VitaliMostowoj/dawcontrol_hw/dawcontrol.kicad_sch

## KiCad design dawcontrol.kicad_sch (2026-11-02)

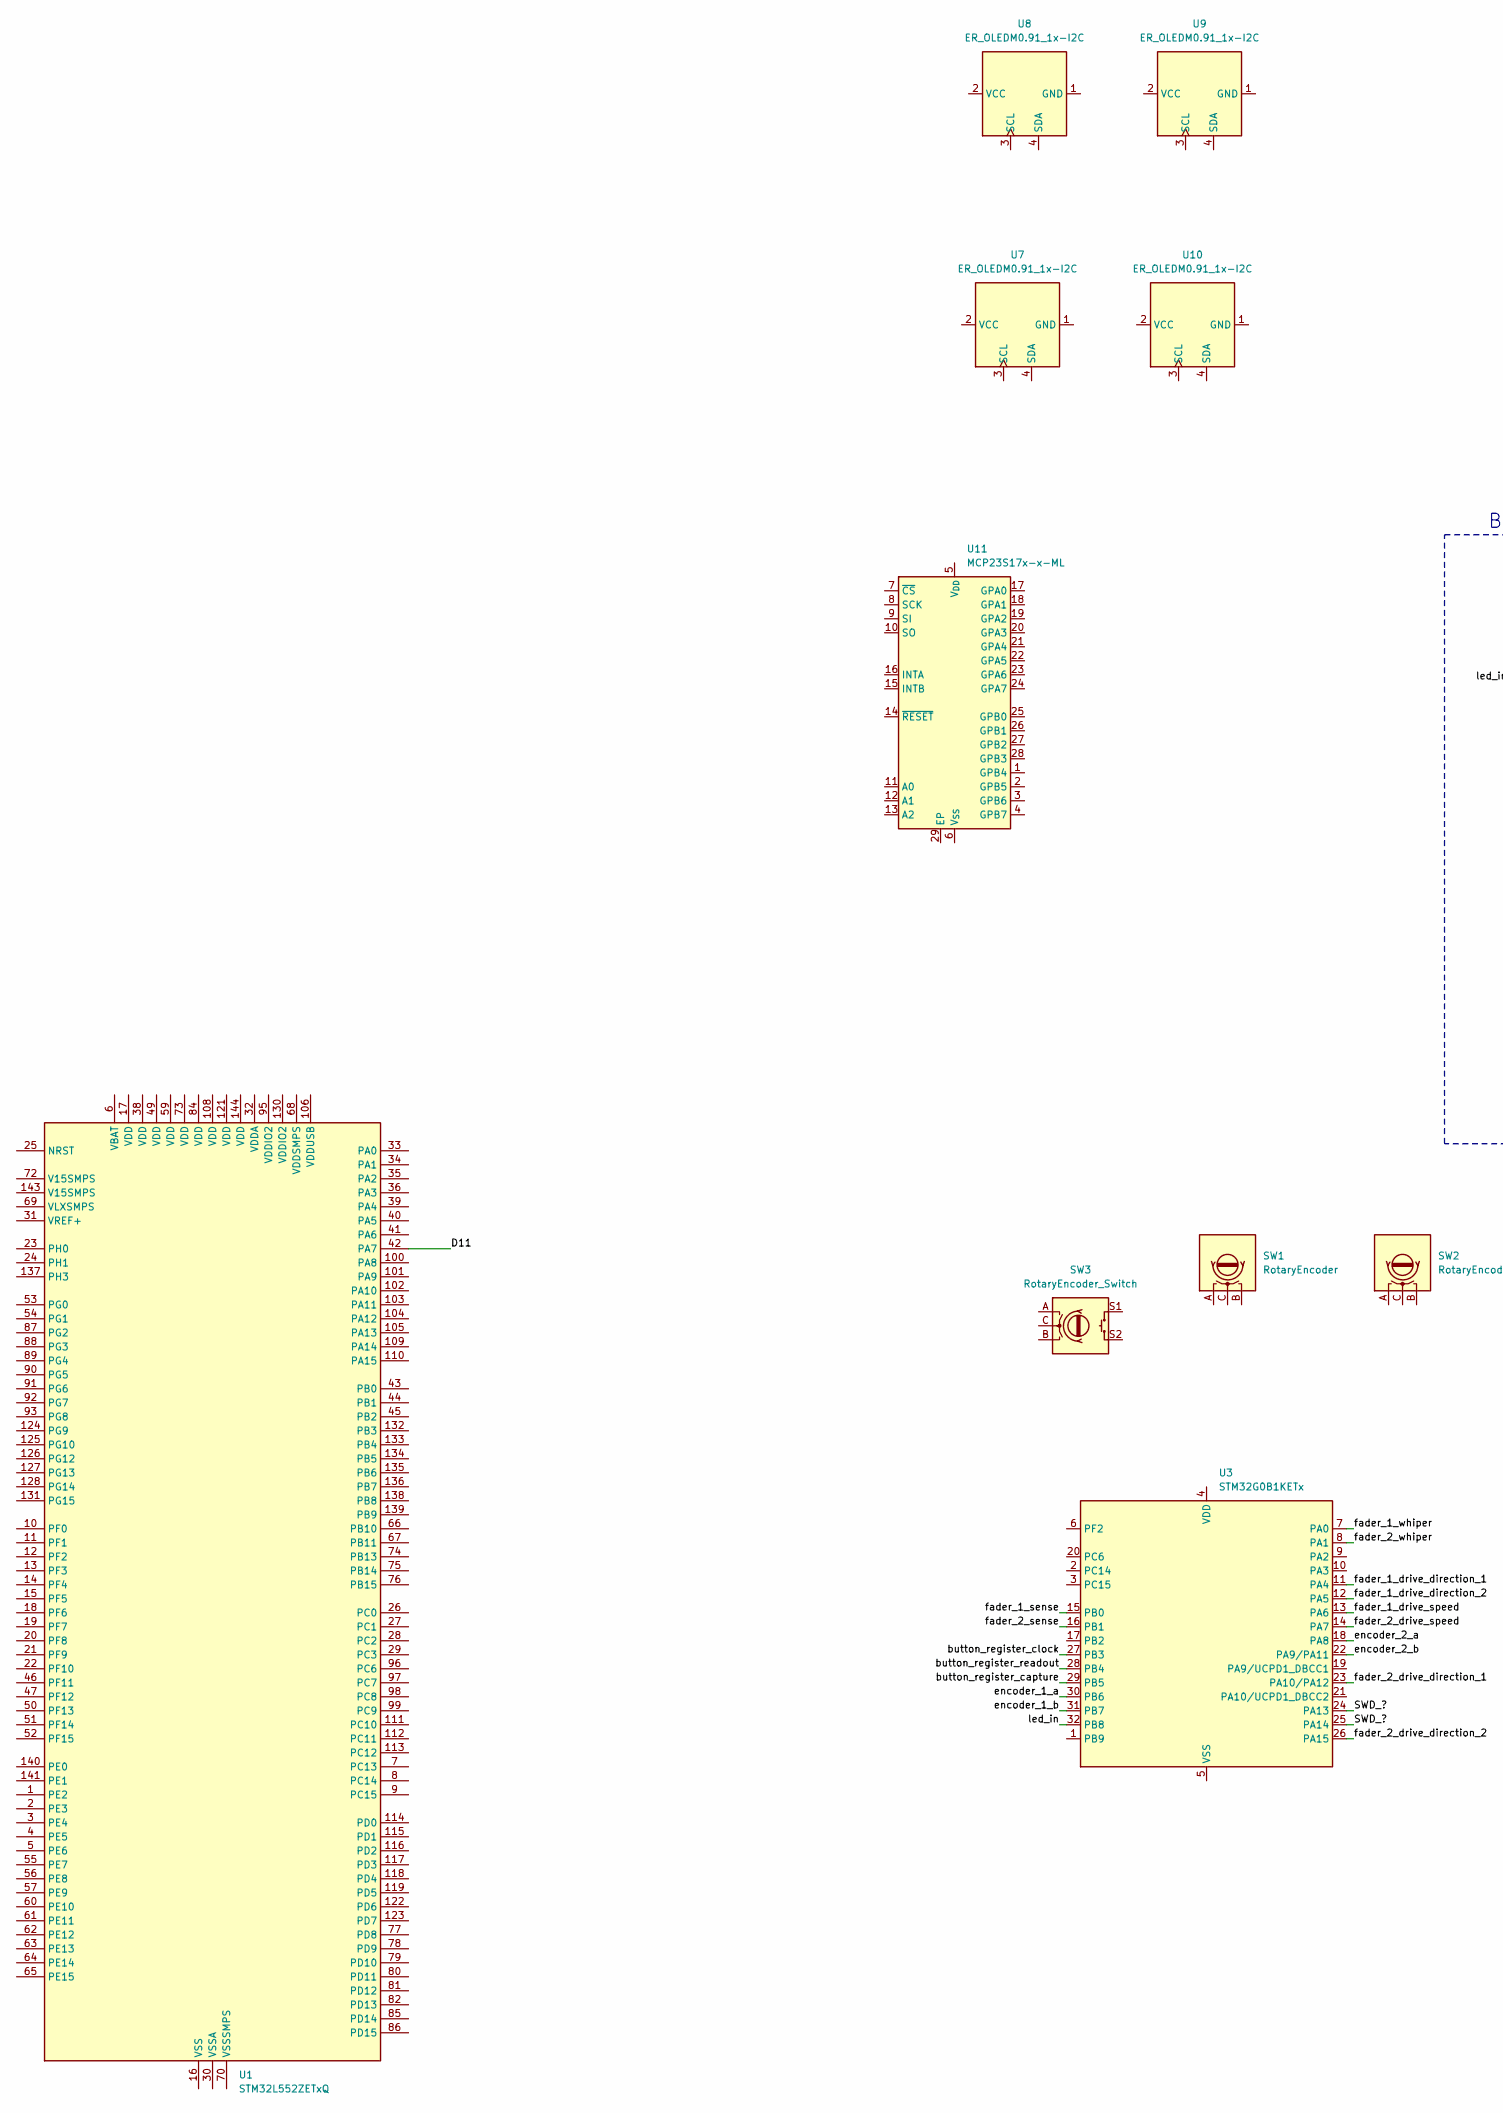
[picture p1: schematic dawcontrol.kicad_sch, part in row 1, column 1]

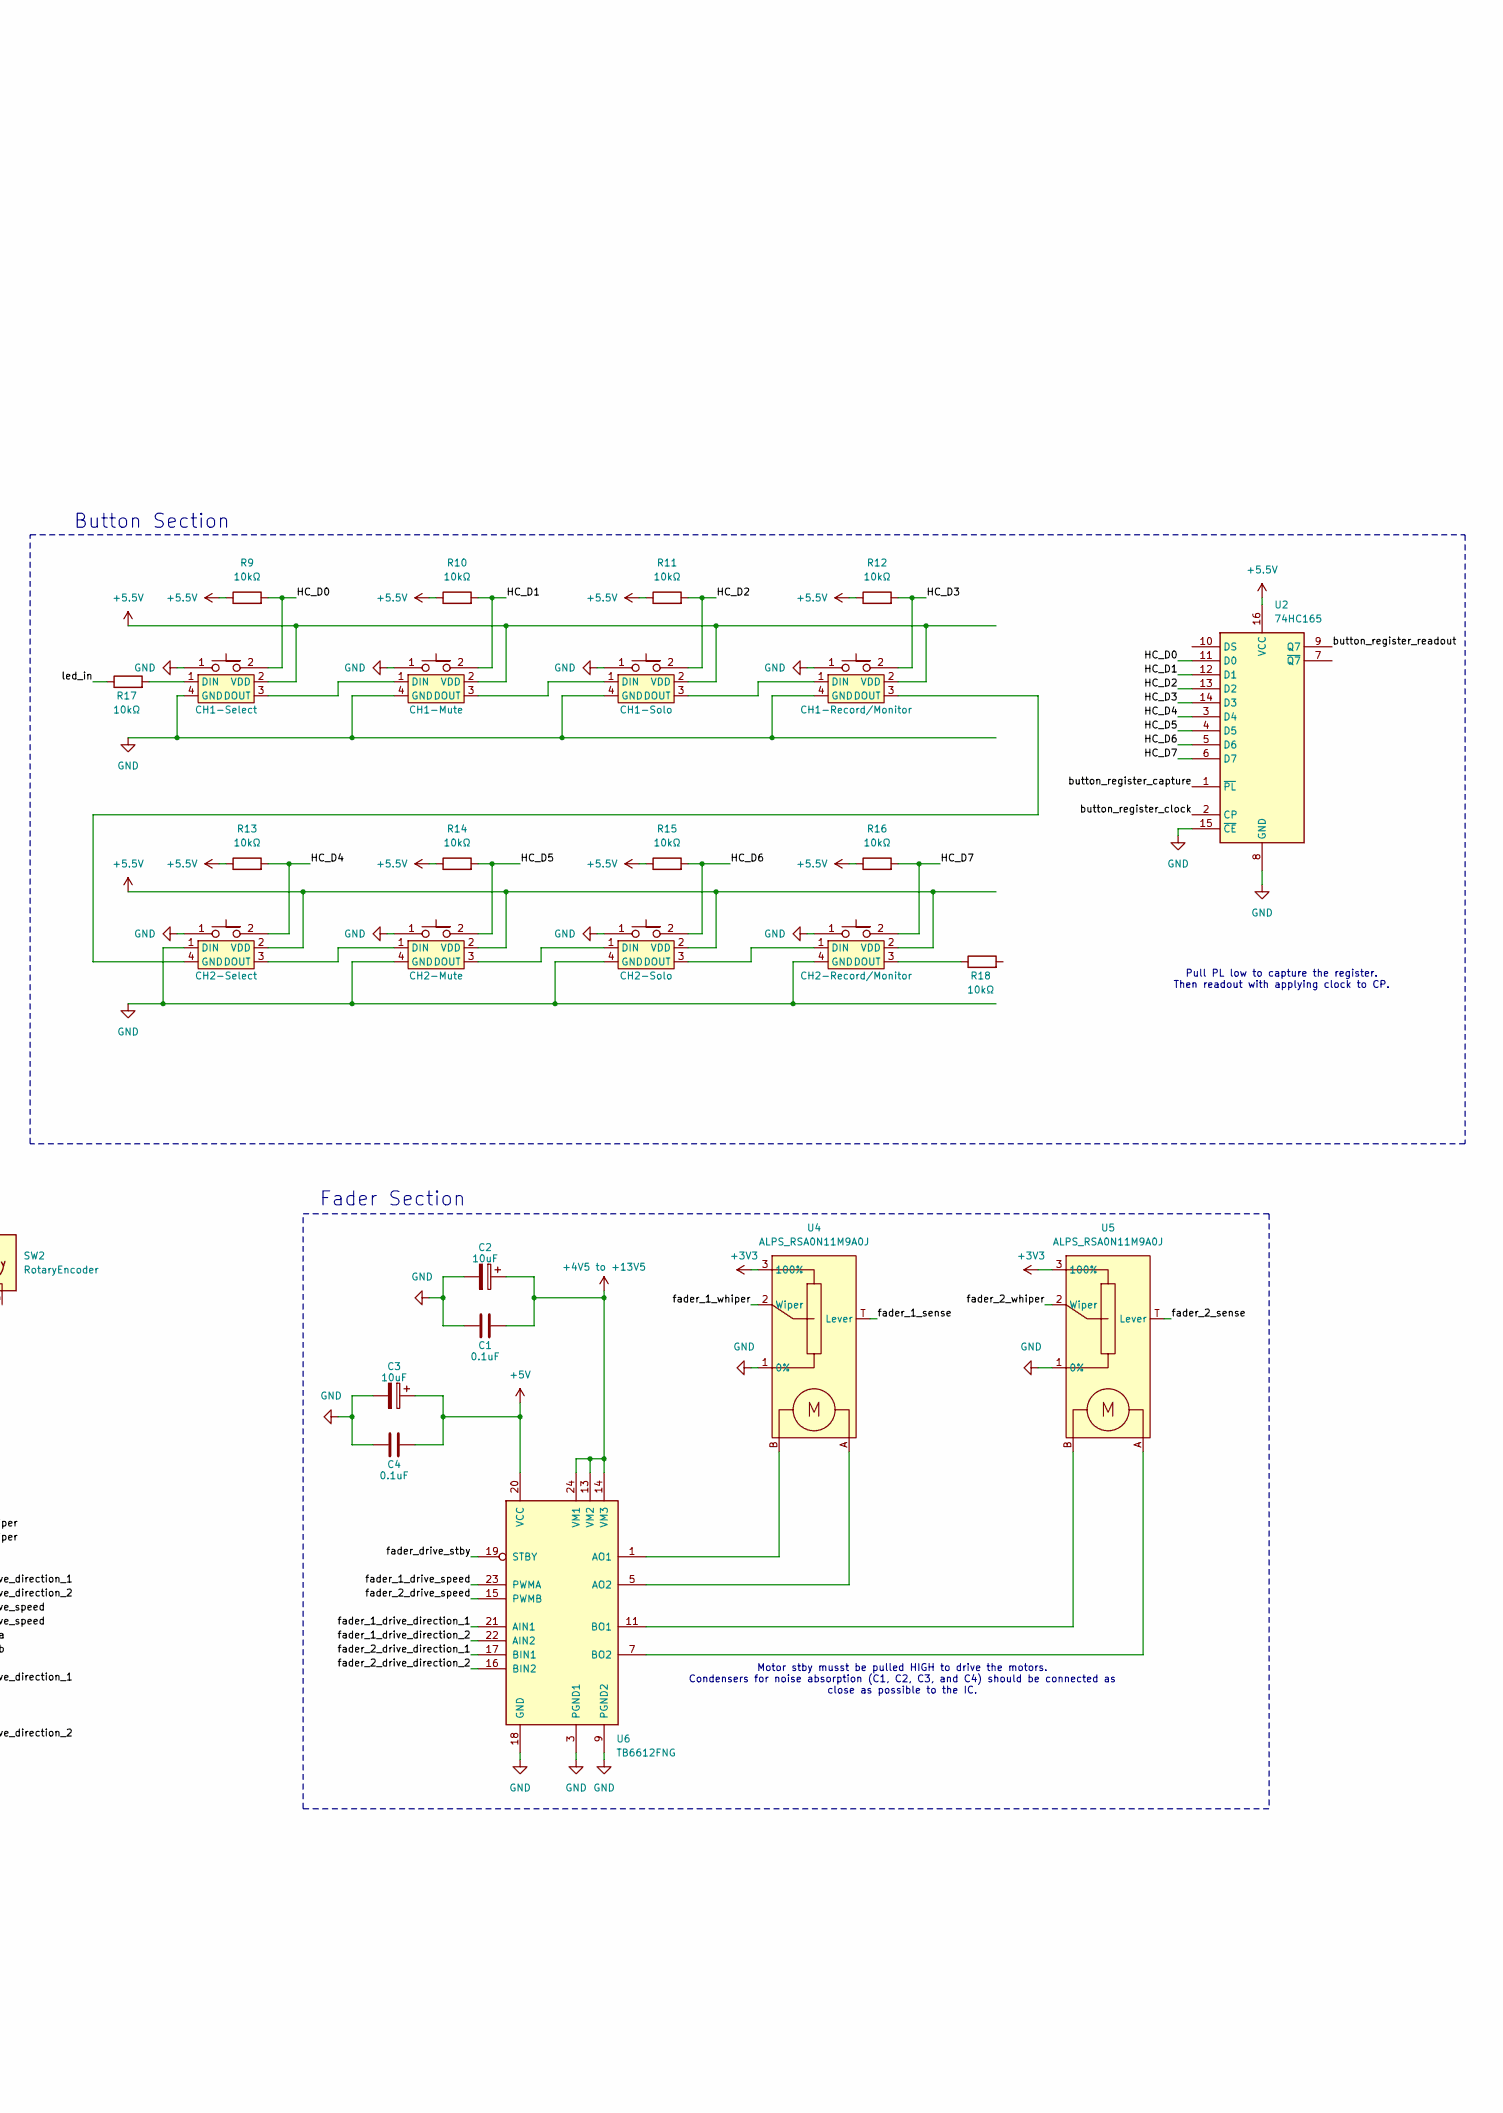
[picture p2: schematic dawcontrol.kicad_sch, part in row 1, column 2]

Parts:
C1, C4: 0.1uF
C2, C3: 10uF
CH1-Mute, CH1-Record/Monitor, CH1-Select, CH1-Solo, CH2-Mute, CH2-Record/Monitor, CH2-Select, CH2-Solo: CherryMX_SK6812MINI-E
R9, R10, R11, R12, R13, R14, R15, R16, R17, R18: 10kΩ
SW1, SW2: RotaryEncoder
SW3: RotaryEncoder_Switch
U1: STM32L552ZETxQ; LQFP-144_20x20mm_P0.5mm
U2: 74HC165
U3: STM32G0B1KETx; LQFP-32_7x7mm_P0.8mm
U4, U5: ALPS_RSA0N11M9A0J
U6: TB6612FNG; SSOP-24_5.3x8.2mm_P0.65mm
U7, U8, U9, U10: ER_OLEDM0.91_1x-I2C
U11: MCP23S17x-x-ML; QFN-28-1EP_6x6mm_P0.65mm_EP4.25x4.25mm

Connections:
+3V3: U4.3 (100%), U5.3 (100%)
+4V5 to +13V5: C1.2, C2.1, U6.13 (VM2), U6.14 (VM3), U6.24 (VM1)
+5.5V: CH1-Mute.2, CH1-Record/Monitor.2, CH1-Select.2, CH1-Solo.2, CH2-Mute.2, CH2-Record/Monitor.2, CH2-Select.2, CH2-Solo.2, R9.1, R10.1, R11.1, R12.1, R13.1, R14.1, R15.1, R16.1, U2.16 (VCC)
+5V: C3.1, C4.2, U6.20 (VCC)
D11: U1.42 (PA7)
GND: C1.1, C2.2, C3.2, C4.1, CH1-Mute.1, CH1-Mute.4 (GND), CH1-Record/Monitor.1, CH1-Record/Monitor.4 (GND), CH1-Select.1, CH1-Select.4 (GND), CH1-Solo.1, CH1-Solo.4 (GND), CH2-Mute.1, CH2-Mute.4 (GND), CH2-Record/Monitor.1, CH2-Record/Monitor.4 (GND), CH2-Select.1, CH2-Solo.1, CH2-Solo.4 (GND), U2.8 (GND), U2.15 (~CE), U4.1 (0%), U5.1 (0%), U6.3 (PGND1), U6.4 (PGND1), U6.9 (PGND2), U6.10 (PGND2), U6.18 (GND)
HC_D0: CH1-Select.2, R9.2, U2.11 (D0)
HC_D1: CH1-Mute.2, R10.2, U2.12 (D1)
HC_D2: CH1-Solo.2, R11.2, U2.13 (D2)
HC_D3: CH1-Record/Monitor.2, R12.2, U2.14 (D3)
HC_D4: CH2-Select.2, R13.2, U2.3 (D4)
HC_D5: CH2-Mute.2, R14.2, U2.4 (D5)
HC_D6: CH2-Solo.2, R15.2, U2.5 (D6)
HC_D7: CH2-Record/Monitor.2, R16.2, U2.6 (D7)
unnamed: CH1-Mute.1, CH1-Select.3 (DOUT)
unnamed: CH1-Mute.3 (DOUT), CH1-Solo.1
unnamed: CH1-Record/Monitor.1, CH1-Solo.3 (DOUT)
unnamed: CH1-Record/Monitor.3 (DOUT), CH2-Select.4 (GND)
unnamed: CH1-Select.1, R17.2
unnamed: CH2-Mute.1, CH2-Select.3 (DOUT)
unnamed: CH2-Mute.3 (DOUT), CH2-Solo.1
unnamed: CH2-Record/Monitor.1, CH2-Solo.3 (DOUT)
unnamed: CH2-Record/Monitor.3 (DOUT), R18.1
unnamed: U1.16 (VSS), U1.37 (VSS), U1.48 (VSS), U1.58 (VSS), U1.71 (VSS), U1.83 (VSS), U1.94 (VSS), U1.107 (VSS), U1.120 (VSS), U1.129 (VSS), U1.142 (VSS)
unnamed: U4.A, U6.5 (AO2), U6.6 (AO2)
unnamed: U4.B, U6.1 (AO1), U6.2 (AO1)
unnamed: U5.A, U6.7 (BO2), U6.8 (BO2)
unnamed: U5.B, U6.11 (BO1), U6.12 (BO1)
SWD_?: U3.24 (PA13), U3.25 (PA14)
button_register_capture: U2.1 (~PL), U3.29 (PB5)
button_register_clock: U2.2 (CP), U3.27 (PB3)
button_register_readout: U2.9 (Q7), U3.28 (PB4)
encoder_1_a: U3.30 (PB6)
encoder_1_b: U3.31 (PB7)
encoder_2_a: U3.18 (PA8)
encoder_2_b: U3.22 (PA9/PA11)
fader_1_drive_direction_1: U3.11 (PA4), U6.21 (AIN1)
fader_1_drive_direction_2: U3.12 (PA5), U6.22 (AIN2)
fader_1_drive_speed: U3.13 (PA6), U6.23 (PWMA)
fader_1_sense: U3.15 (PB0), U4.T (Lever)
fader_1_whiper: U3.7 (PA0), U4.2 (Wiper)
fader_2_drive_direction_1: U3.23 (PA10/PA12), U6.17 (BIN1)
fader_2_drive_direction_2: U3.26 (PA15), U6.16 (BIN2)
fader_2_drive_speed: U3.14 (PA7), U6.15 (PWMB)
fader_2_sense: U3.16 (PB1), U5.T (Lever)
fader_2_whiper: U3.8 (PA1), U5.2 (Wiper)
fader_drive_stby: U6.19 (STBY)
led_in: R17.1, U3.32 (PB8)

Notes on the sheet:
Fader Section
Button Section
Motor stby musst be pulled HIGH to drive the motors. Condensers for noise absorption (C1, C2, C3, and C4) should be connected as close as possible to the IC.
Pull PL low to capture the register. Then readout with applying clock to CP.
