VitaliMostowoj/dawcontrol_hw/cube/cube.ioc

Mcu.UserName=STM32G0B1KETx
PA0.Signal=GPIO_Output
PA1.Signal=GPIO_Output
PA2.Signal=GPIO_Input
PB3.Signal=SPI1_SCK
PB4.Signal=SPI1_MISO
PB5.Signal=GPIO_Output
