VitaliMostowoj/dawcontrol_hw/(commit log)

2026-10-27 Add kicad librarys
2026-10-28 Add button section for schematic
